h4ctar/slop-speedo/.opencode/commands/next.md

---
description: Take the next task from TODO.md, implement, verify, review, and commit
---

Work on the next task in `TODO.md`: $ARGUMENTS
If no task was named above, take the first unchecked item.

1. **Plan**: read the relevant code and `AGENTS.md`. If the task needs a CubeMX change (new pin, peripheral, timer, interrupt, or clock config), stop and tell me exactly what to set in STM32CubeMX. Don't hand-edit generated config. If the task is ambiguous, ask before writing code.
2. **Implement**: keep changes small. In generated files, edit only inside `USER CODE` blocks.
3. **Verify**: run `firmware/check.sh` until it passes with no warnings.
4. **Review**: launch the `firmware-reviewer` subagent for firmware changes, or `hardware-reviewer` for `hardware/` changes (both if both changed), and fix every real issue it reports. Re-run `check.sh` afterwards for firmware changes.
5. **Hardware test**: flash with `firmware/flash.sh` and debug on the board yourself, without asking. If the OLED bus locks up after flashing (SDA held low), the user must power-cycle the board. Verify what you can yourself by inspecting memory on the running board with openocd (don't halt it: halting can interrupt I2C transfers). Then write a short checklist of what I should confirm on the board (needle, OLED, button behaviour).
6. **Commit**: don't commit until I've checked the work; never push. Tick the item in `TODO.md` only after I confirm the hardware test passes; until then leave the item unchecked with a note "(awaiting hardware test)".
