h4ctar/slop-speedo/.opencode/commands/build.md

---
description: Strict Debug + Release build (same as CI) with memory usage
---

Strict build output (`firmware/check.sh`, -Werror):

!`firmware/check.sh 2>&1; echo "exit status: $?"`

If it failed, find the cause and fix it, then re-run `firmware/check.sh`. If it passed, just report flash/RAM usage in one line.
