h4ctar/slop-speedo/firmware/Core/Inc/main.h

#define M3_Pin GPIO_PIN_4
#define M3_GPIO_Port GPIOA
#define M4_Pin GPIO_PIN_5
#define M4_GPIO_Port GPIOA
#define VOLTS_Pin GPIO_PIN_7
#define VOLTS_GPIO_Port GPIOA
#define M1_Pin GPIO_PIN_4
#define M1_GPIO_Port GPIOB
#define M2_Pin GPIO_PIN_5
#define M2_GPIO_Port GPIOB
