h4ctar/slop-speedo/firmware/Core/Src/screen.c

#include <math.h>
#include <screen.h>
#include <stdlib.h>
#include <string.h>
#include "stm32f1xx_hal.h"
#include "i2c.h"

#define I2C_PORT      hi2c1
#define I2C_ADDR      (0x3C << 1)
#define FONT_WIDTH    16
#define FONT_HEIGHT   26
#define SCREEN_WIDTH  128
#define SCREEN_HEIGHT 32
#define BUFFER_SIZE   (SCREEN_WIDTH * SCREEN_HEIGHT / 8)

static uint8_t buffer[BUFFER_SIZE];

uint32_t x = 0;
uint32_t y = SCREEN_HEIGHT - FONT_HEIGHT;

// clang-format off
const uint16_t font[] = {
  0x0000,0x0000,0x0000,0x0000,0x0000,0x0000,0x0000,0x0000,0x0000,0x0000,0x0000,0x0000,0x0000,0x0000,0x0000,0x0000,0x0000,0x0000,0x0000,0x0000,0x0000,0x0000,0x0000,0x0000,0x0000,0x0000, // Ascii = [ ]
  0x03E0,0x03E0,0x03E0,0x03E0,0x03E0,0x03E0,0x03E0,0x03E0,0x03C0,0x03C0,0x01C0,0x01C0,0x01C0,0x01C0,0x01C0,0x0000,0x0000,0x0000,0x03E0,0x03E0,0x03E0,0x0000,0x0000,0x0000,0x0000,0x0000, // Ascii = [!]
  0x1E3C,0x1E3C,0x1E3C,0x1E3C,0x1E3C,0x1E3C,0x1E3C,0x0000,0x0000,0x0000,0x0000,0x0000,0x0000,0x0000,0x0000,0x0000,0x0000,0x0000,0x0000,0x0000,0x0000,0x0000,0x0000,0x0000,0x0000,0x0000, // Ascii = ["]
  0x01CE,0x03CE,0x03DE,0x039E,0x039C,0x079C,0x3FFF,0x7FFF,0x0738,0x0F38,0x0F78,0x0F78,0x0E78,0xFFFF,0xFFFF,0x1EF0,0x1CF0,0x1CE0,0x3CE0,0x3DE0,0x39E0,0x0000,0x0000,0x0000,0x0000,0x0000, // Ascii = [#]
  0x03FC,0x0FFE,0x1FEE,0x1EE0,0x1EE0,0x1EE0,0x1EE0,0x1FE0,0x0FE0,0x07E0,0x03F0,0x01FC,0x01FE,0x01FE,0x01FE,0x01FE,0x01FE,0x01FE,0x3DFE,0x3FFC,0x0FF0,0x01E0,0x01E0,0x0000,0x0000,0x0000, // Ascii = [$]
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

  writeCommand(0xA8); //--set multiplex ratio(1 to 64) - CHECK

  writeCommand(0x1F); //

  writeCommand(0xA4); //0xa4,Output follows RAM content;0xa5,Output ignores RAM content

  writeCommand(0xD3); //-set display offset - CHECK
  writeCommand(0x00); //-not offset

  writeCommand(0xD5); //--set display clock divide ratio/oscillator frequency
  writeCommand(0xF0); //--set divide ratio

  writeCommand(0xD9); //--set pre-charge period
  writeCommand(0x22); //

  writeCommand(0xDA); //--set com pins hardware configuration - CHECK
  writeCommand(0x02);

  writeCommand(0xDB); //--set vcomh
  writeCommand(0x20); //0x20,0.77xVcc

  writeCommand(0x8D); //--set DC-DC enable
  writeCommand(0x14); //

  writeCommand(0xAF); //--turn on SSD1306 panel

  // Clear screen
  clearScreen();

  // Flush buffer to screen
  updateScreen();
}

/* Fill the whole screen with the given color */
void clearScreen() {
  memset(buffer, 0x00, sizeof(buffer));
}

/* Write the screenbuffer with changed to the screen */
void updateScreen() {
  // Write data to each page of RAM. Number of pages
  // depends on the screen height:
  //
  //  * 32px   ==  4 pages
  //  * 64px   ==  8 pages
  //  * 128px  ==  16 pages
  for (uint8_t i = 0; i < SCREEN_HEIGHT / 8; i++) {
    writeCommand(0xB0 + i); // Set the current RAM page address.
    writeCommand(0x00);
    writeCommand(0x10);
    writeData(&buffer[SCREEN_WIDTH * i], SCREEN_WIDTH);
  }
}

/*
 * Draw one pixel in the screenbuffer
 * X => X Coordinate
 * Y => Y Coordinate
 * color => Pixel color
 */
void drawPixel(uint8_t x, uint8_t y) {
  if (x >= SCREEN_WIDTH || y >= SCREEN_HEIGHT) {
    // Don't write outside the buffer
    return;
  }

  buffer[x + (y / 8) * SCREEN_WIDTH] |= 1 << (y % 8);
}

/*
 * Draw 1 char to the screen buffer
 * ch       => char om weg te schrijven
 * color    => Black or White
 */
void drawCharacter(char ch) {
  uint32_t i, b, j;

  // Check if character is valid
  if (ch < 32 || ch > 126)
    return;

  // Check remaining space on current line
  if (SCREEN_WIDTH < (x + FONT_WIDTH) || SCREEN_HEIGHT < (y + FONT_HEIGHT)) {
    // Not enough space on current line
    return;
  }

  // Use the font to write
  for (i = 0; i < FONT_HEIGHT; i++) {
    b = font[(ch - 32) * FONT_HEIGHT + i];
    for (j = 0; j < FONT_WIDTH; j++) {
      if ((b << j) & 0x8000) {
        drawPixel(x + j, (y + i));
      }
    }
  }

  // The current space is now taken
  x += FONT_WIDTH;
}

/* Write full string to screenbuffer */
void displayString(char *str) {
  x = 0;

  while (*str) {
    drawCharacter(*str);
    str++;
  }
}
