h4ctar/slop-speedo/firmware/Core/Src/rtc.c

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
/* Includes ------------------------------------------------------------------*/
#include "rtc.h"

/* USER CODE BEGIN 0 */
/* BKP_DR1 magic: non-zero once the RTC time has been set at least once. The
 * register lives in the Vbat domain: any reset that keeps the board powered
 * (flash, debugger, NRST, watchdog, brownout) preserves both the flag and the
 * counter, so MX_RTC_Init skips re-setting the time. With the J5 Vbat battery
 * fitted they also survive full power loss (the RTC keeps ticking on LSE);
 * without it, both are cleared and the clock restarts at the default time. */
#define RTC_TIME_SET_MAGIC 0x5254U /* "RT" */

/* USER CODE END 0 */

RTC_HandleTypeDef hrtc;

/* RTC init function */
void MX_RTC_Init(void)
{

  RTC_TimeTypeDef sTime = {0};
  RTC_DateTypeDef DateToUpdate = {0};

  /** Initialize RTC Only
  */
  hrtc.Instance = RTC;
  hrtc.Init.AsynchPrediv = RTC_AUTO_1_SECOND;
  hrtc.Init.OutPut = RTC_OUTPUTSOURCE_NONE;
  if (HAL_RTC_Init(&hrtc) != HAL_OK)
  {
    Error_Handler();
  }

  /* USER CODE BEGIN Check_RTC_BKUP */
  if (HAL_RTCEx_BKUPRead(&hrtc, RTC_BKP_DR1) == RTC_TIME_SET_MAGIC)
  {
    /* Time and flag live in the Vbat domain and survived the last reset:
     * don't clobber the clock, keep the counter running. */
    return;
  }
  /* USER CODE END Check_RTC_BKUP */

  /** Initialize RTC and set the Time and Date
  */
  sTime.Hours = 0x0;
  sTime.Minutes = 0x0;
  sTime.Seconds = 0x0;

  if (HAL_RTC_SetTime(&hrtc, &sTime, RTC_FORMAT_BCD) != HAL_OK)
  {
    Error_Handler();
  }
  DateToUpdate.WeekDay = RTC_WEEKDAY_MONDAY;
  DateToUpdate.Month = RTC_MONTH_JANUARY;
  DateToUpdate.Date = 0x1;
  DateToUpdate.Year = 0x0;

  if (HAL_RTC_SetDate(&hrtc, &DateToUpdate, RTC_FORMAT_BCD) != HAL_OK)
  {
    Error_Handler();
  }
  /* USER CODE BEGIN RTC_Init 2 */
  /* First boot (or all power lost): the default time was just set - remember
   * it so the next reset doesn't zero the clock again. */
  HAL_RTCEx_BKUPWrite(&hrtc, RTC_BKP_DR1, RTC_TIME_SET_MAGIC);
  /* USER CODE END RTC_Init 2 */

}

void HAL_RTC_MspInit(RTC_HandleTypeDef* rtcHandle)
{

  if(rtcHandle->Instance==RTC)
  {
    HAL_PWR_EnableBkUpAccess();
    /* Enable BKP CLK enable for backup registers */
    __HAL_RCC_BKP_CLK_ENABLE();
    /* RTC clock enable */
    __HAL_RCC_RTC_ENABLE();
  }
}

void HAL_RTC_MspDeInit(RTC_HandleTypeDef* rtcHandle)
{

  if(rtcHandle->Instance==RTC)
  {
    /* Peripheral clock disable */
    __HAL_RCC_RTC_DISABLE();
  }
}
