h4ctar/slop-speedo/firmware/app/odo.h

#ifndef __ODO_H__
#define __ODO_H__

#include "function.h"

// The ODOMETER display function: total distance, in the shared unit.
// Accumulation from the wheel pulses and flash persistence land with the
// speed-sensor TODO.
extern const Function odo_function;

#endif
