h4ctar/slop-speedo/firmware/app/trip.h

#ifndef __TRIP_H__
#define __TRIP_H__

#include "function.h"

// The TRIP display function: distance since the last reset (long press), in
// the shared unit. Accumulation and persistence land with the speed-sensor
// TODO.
extern const Function trip_function;

#endif
