h4ctar/slop-speedo/(commit log)

2026-10-10 Silence kibot W135 and mounting-hole warnings
2026-10-10 Rename speedo-code to firmware and speedo-pcb to hardware
2026-10-10 Tick I2C recovery item after hardware test
2026-10-10 Use 16-bit modular subtraction for motor step timing
2026-10-10 Clamp motor position as a float before conversion
2026-10-10 Service the motor from loop with catch-up stepping
2026-10-10 Define the feature set: speedo needle, MODE button functions, units
2026-10-10 Note speed sensor design decision and parts order
2026-10-10 Add MODE button with short/long press detection and stub function UI
2026-10-10 Add clock set mode to the MODE button UI
2026-10-11 Add battery voltage function on the ADC with oversampling
2026-10-11 Switch the OLED font to a condensed classic-gauge style, generated by tools/gen_font.py
2026-10-11 Mark the UI function switcher done
2026-10-11 Ignore KiCad's .history directory
2026-10-11 Correct the 4V-rail exposure note: J4-powered only, ST-Link-only sessions are 3.3V
2026-11-08 Run the RTC on LSE so the Vbat battery keeps the clock ticking
    With the RTC on LSI (VDD domain) the Vbat battery held the backup
    registers but the clock stopped while the board was unpowered. CubeMX
    now selects the fitted 32.768 kHz crystal (X2) as the RTC clock, which
    runs from Vbat. Tested on the board: the time advances across a full
    power loss and no longer drifts by up to 30%.
2026-11-08 Add TODO items: test points, larger resistor footprints, dial backlight, face plates
