h4ctar/slop-speedo/(notices)

Notices in the files:
speedo-code/Core/Src/i2c.c:
Copyright (c) 2025 STMicroelectronics.
All rights reserved.
This software is licensed under terms that can be found in the LICENSE file
